sellai-youcef/sova/assets/hero.jpg

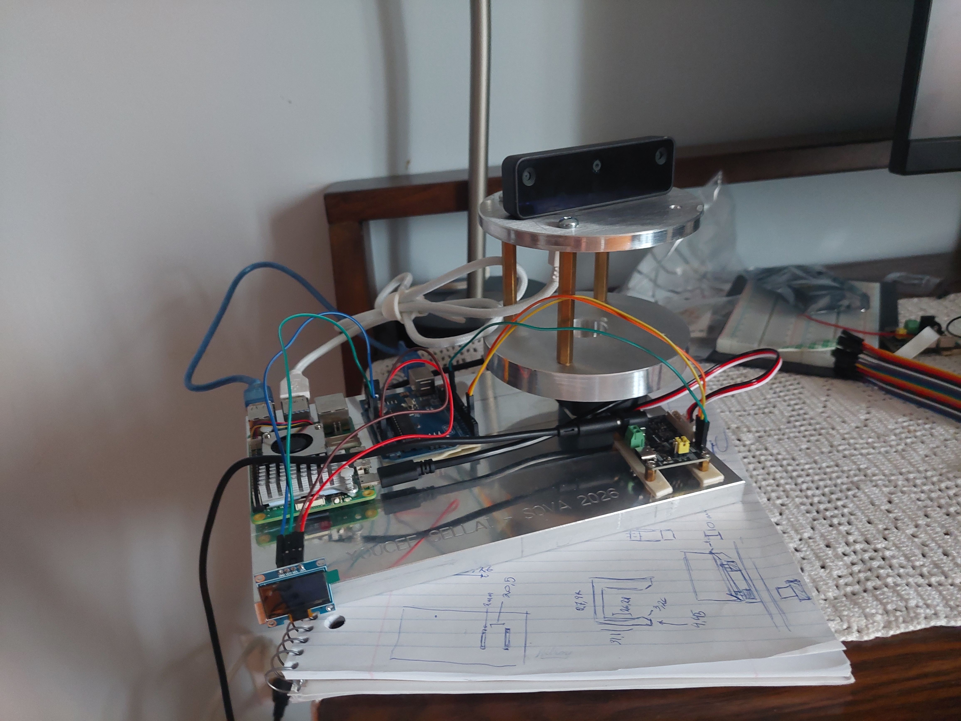
assets/hero.jpg
