sellai-youcef/sova/(commit log)

2026-09-06 Perception node publishes horizontal offset for tracking; bridge node and arduino display live search state and distance on OLED
2026-09-06 Add arduino sketch: OLED displays search/found/distance states and live-updates target distances over serial
2026-09-21 Close the perception-to-actuation loop: servo tracking via software serial on pins 2/3
2026-09-21 Close perception-to-action loop: OAK-D detection drives servo tracking via proportional offset control. tracking still oscillates at current gain settings.
    [arduino_bridge_node.py]
2026-10-03 Change PROPORTIONAL_GAIN from 4 to 1.0; it fixed oscillation
    [arduino_bridge_node.py]
