sellai-youcef/sova/assets/stock.jpg

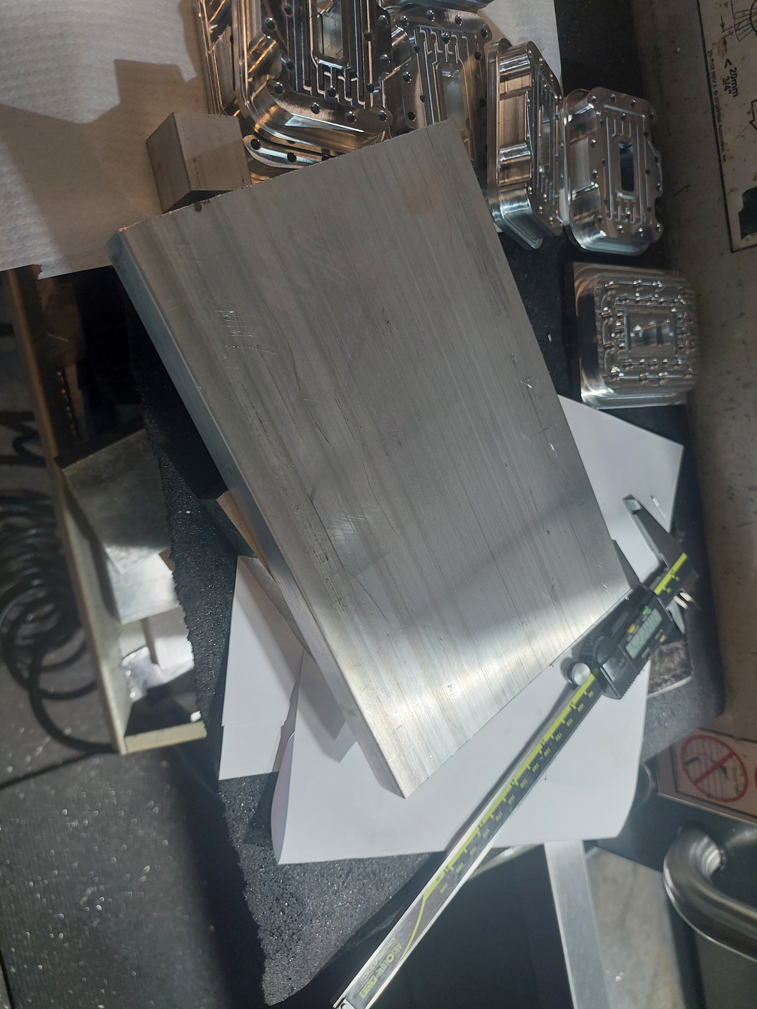
[picture p1: assets/stock.jpg]
assets/stock.jpg
